555AA670/ELF2_Inspection_Robot/2_STM32_Code/STM32_Project/app/MDK-ARM/build_log.txt

*** Using Compiler 'V5.06 update 5 (build 528)', folder: 'C:\Keil_v5\ARM\ARMCC\Bin'
Rebuild target 'app'
assembling startup_stm32g431xx.s...
compiling OLED_Data.c...
compiling my_spi.c...
compiling stm32g4xx_hal_flash_ramfunc.c...
compiling stm32g4xx_hal_dma_ex.c...
compiling w25q64.c...
compiling ina219_sensor.c...
compiling stm32g4xx_hal_uart.c...
compiling main.c...
../Core/Src/main.c(143): warning:  #550-D: variable "servo_imu_pid_integral"  was set but never used
  static float servo_imu_pid_integral = 0.0f;
../Core/Src/main.c(144): warning:  #550-D: variable "servo_imu_pid_prev_error"  was set but never used
  static float servo_imu_pid_prev_error = 0.0f;
../Core/Src/main.c: 2 warnings, 0 errors
compiling stm32g4xx_it.c...
compiling stm32g4xx_hal_rcc.c...
compiling uart2_oled.c...
compiling icm42688_imu.c...
compiling motor.c...
../Core/Src/motor.c(35): warning:  #550-D: variable "motor_left_mode"  was set but never used
  static MotorDriveMode motor_left_mode = MOTOR_DRIVE_STOP;
../Core/Src/motor.c(36): warning:  #550-D: variable "motor_right_mode"  was set but never used
  static MotorDriveMode motor_right_mode = MOTOR_DRIVE_STOP;
../Core/Src/motor.c: 2 warnings, 0 errors
compiling my_rtc.c...
compiling stm32g4xx_hal_cortex.c...
compiling servo.c...
compiling board.c...
compiling stm32g4xx_hal_flash.c...
compiling stm32g4xx_hal.c...
compiling stm32g4xx_hal_gpio.c...
compiling stm32g4xx_hal_flash_ex.c...
compiling stm32g4xx_hal_rtc.c...
compiling stm32g4xx_hal_pwr.c...
compiling fusion_tracker.c...
compiling stm32g4xx_hal_rcc_ex.c...
compiling stm32g4xx_hal_msp.c...
compiling stm32g4xx_hal_rtc_ex.c...
compiling stm32g4xx_hal_dma.c...
compiling stm32g4xx_hal_pwr_ex.c...
compiling stm32g4xx_hal_exti.c...
compiling stm32g4xx_hal_uart_ex.c...
compiling OLED.c...
