555AA670/ELF2_Inspection_Robot/2_STM32_Code/STM32_Project/G431bootloader/MDK-ARM/build_log.txt

*** Using Compiler 'V5.06 update 5 (build 528)', folder: 'C:\Keil_v5\ARM\ARMCC\Bin'
Build target 'G431bootloader'
compiling main.c...
linking...
Program Size: Code=8010 RO-data=530 RW-data=52 ZI-data=3692  
FromELF: creating hex file...
"G431bootloader\G431bootloader.axf" - 0 Error(s), 0 Warning(s).
Build Time Elapsed:  00:00:02
