555AA670/ELF2_Inspection_Robot/2_STM32_Code/STM32_Project/app/Core/Src/my_rtc.c

#include "my_rtc.h"

RTC_HandleTypeDef hrtc;
volatile uint8_t rtc_alarm_triggered = 0;

void MyRTC_Init(void)
{
  RCC_OscInitTypeDef RCC_OscInitStruct = {0};
  RCC_PeriphCLKInitTypeDef PeriphClkInit = {0};

  /* Enable LSE clock */
  RCC_OscInitStruct.OscillatorType = RCC_OSCILLATORTYPE_LSE;
  RCC_OscInitStruct.LSEState = RCC_LSE_ON;
  if (HAL_RCC_OscConfig(&RCC_OscInitStruct) != HAL_OK)
  {
    Error_Handler();
  }

  /* Select LSE as RTC clock source */
  PeriphClkInit.PeriphClockSelection = RCC_PERIPHCLK_RTC;
  PeriphClkInit.RTCClockSelection = RCC_RTCCLKSOURCE_LSE;
  if (HAL_RCCEx_PeriphCLKConfig(&PeriphClkInit) != HAL_OK)
  {
    Error_Handler();
  }

  /* Enable RTC Clock */
  __HAL_RCC_RTC_ENABLE();

  hrtc.Instance = RTC;
  hrtc.Init.HourFormat = RTC_HOURFORMAT_24;
  hrtc.Init.AsynchPrediv = 127;
  hrtc.Init.SynchPrediv = 255; // LSE is 32768Hz (32768 / 128 = 256) -> 255
  hrtc.Init.OutPut = RTC_OUTPUT_DISABLE;
  hrtc.Init.OutPutRemap = RTC_OUTPUT_REMAP_NONE;
  hrtc.Init.OutPutPolarity = RTC_OUTPUT_POLARITY_HIGH;
  hrtc.Init.OutPutType = RTC_OUTPUT_TYPE_OPENDRAIN;
  hrtc.Init.OutPutPullUp = RTC_OUTPUT_PULLUP_NONE;
  
  if (HAL_RTC_Init(&hrtc) != HAL_OK)
  {
    Error_Handler();
  }

  /* Check if RTC is already configured by reading Backup Register */
  if (HAL_RTCEx_BKUPRead(&hrtc, RTC_BKP_DR1) != 0x32F2)
  {
    /* Set Time: 12:00:00 */
    MyRTC_SetTime(12, 0, 0);

    /* Set Date: 2026-01-01 */
    RTC_DateTypeDef sDate = {0};
    sDate.Year = 26;
    sDate.Month = RTC_MONTH_JANUARY;
    sDate.Date = 1;
    sDate.WeekDay = RTC_WEEKDAY_THURSDAY;
    if (HAL_RTC_SetDate(&hrtc, &sDate, RTC_FORMAT_BIN) != HAL_OK)
    {
      Error_Handler();
    }

    HAL_RTCEx_BKUPWrite(&hrtc, RTC_BKP_DR1, 0x32F2);
  }
}

void MyRTC_SetTime(uint8_t hours, uint8_t minutes, uint8_t seconds)
{
  RTC_TimeTypeDef sTime = {0};
  sTime.Hours = hours;
  sTime.Minutes = minutes;
  sTime.Seconds = seconds;
  sTime.DayLightSaving = RTC_DAYLIGHTSAVING_NONE;
  sTime.StoreOperation = RTC_STOREOPERATION_RESET;

  HAL_RTC_SetTime(&hrtc, &sTime, RTC_FORMAT_BIN);
}

void MyRTC_GetTime(uint8_t *hours, uint8_t *minutes, uint8_t *seconds)
{
  RTC_TimeTypeDef sTime = {0};
  RTC_DateTypeDef sDate = {0};

  /* Must read time then date to unlock the shadow registers */
  HAL_RTC_GetTime(&hrtc, &sTime, RTC_FORMAT_BIN);
  HAL_RTC_GetDate(&hrtc, &sDate, RTC_FORMAT_BIN);

  if (hours) *hours = sTime.Hours;
  if (minutes) *minutes = sTime.Minutes;
  if (seconds) *seconds = sTime.Seconds;
}

void RTC_WKUP_IRQHandler(void)
{
  HAL_RTCEx_WakeUpTimerIRQHandler(&hrtc);
}

void MyRTC_SetAlarmA(uint8_t hours, uint8_t minutes, uint8_t seconds)
{
  RTC_AlarmTypeDef sAlarm = {0};

  sAlarm.AlarmTime.Hours = hours;
  sAlarm.AlarmTime.Minutes = minutes;
  sAlarm.AlarmTime.Seconds = seconds;
  sAlarm.AlarmTime.SubSeconds = 0;
  sAlarm.AlarmTime.DayLightSaving = RTC_DAYLIGHTSAVING_NONE;
  sAlarm.AlarmTime.StoreOperation = RTC_STOREOPERATION_RESET;
  sAlarm.AlarmMask = RTC_ALARMMASK_DATEWEEKDAY; // 忽略日期，仅匹配时分秒
  sAlarm.AlarmSubSecondMask = RTC_ALARMSUBSECONDMASK_ALL;
  sAlarm.AlarmDateWeekDaySel = RTC_ALARMDATEWEEKDAYSEL_DATE;
  sAlarm.AlarmDateWeekDay = 1;
  sAlarm.Alarm = RTC_ALARM_A;

  HAL_RTC_SetAlarm_IT(&hrtc, &sAlarm, RTC_FORMAT_BIN);
  
  /* Enable the Alarm IRQ */
  HAL_NVIC_SetPriority(RTC_Alarm_IRQn, 1, 0);
  HAL_NVIC_EnableIRQ(RTC_Alarm_IRQn);
}

void HAL_RTC_AlarmAEventCallback(RTC_HandleTypeDef *hrtc)
{
  rtc_alarm_triggered = 1;
}
