555AA670/ELF2_Inspection_Robot/2_STM32_Code/STM32_Project/app/Core/Inc/w25q64.h

#ifndef __W25Q64_H
#define __W25Q64_H

#include "main.h"

void W25Q64_Init(void);
void W25Q64_ReadID(uint8_t *MID, uint16_t *DID);
void W25Q64_PageProgram(uint32_t Address, uint8_t *DataArray, uint16_t Count);
void W25Q64_SectorErase(uint32_t Address);
void W25Q64_ReadData(uint32_t Address, uint8_t *DataArray, uint32_t Count);

#endif
