555AA670/ELF2_Inspection_Robot/2_STM32_Code/STM32_Project/app/Core/Src/w25q64.c

#include "w25q64.h"
#include "my_spi.h"
#include "w25q64_ins.h"

void W25Q64_Init(void)
{
    MySPI_Init();
}

void W25Q64_ReadID(uint8_t *MID, uint16_t *DID)
{
    MySPI_Start();
    MySPI_SwapByte(W25Q64_JEDEC_ID);
    *MID = MySPI_SwapByte(W25Q64_DUMMY_BYTE);
    *DID = MySPI_SwapByte(W25Q64_DUMMY_BYTE);
    *DID <<= 8;
    *DID |= MySPI_SwapByte(W25Q64_DUMMY_BYTE);
    MySPI_Stop();
}

void W25Q64_WriteEnable(void)
{
    MySPI_Start();
    MySPI_SwapByte(W25Q64_WRITE_ENABLE);
    MySPI_Stop();
}

void W25Q64_WaitBusy(void)
{
    uint32_t Timeout;
    MySPI_Start();
    MySPI_SwapByte(W25Q64_READ_STATUS_REGISTER_1);
    Timeout = 100000;
    while ((MySPI_SwapByte(W25Q64_DUMMY_BYTE) & 0x01) == 0x01)
    {
        Timeout--;
        if (Timeout == 0)
        {
            break;
        }
    }
    MySPI_Stop();
}

void W25Q64_PageProgram(uint32_t Address, uint8_t *DataArray, uint16_t Count)
{
    uint16_t i;
    
    W25Q64_WriteEnable();
    
    MySPI_Start();
    MySPI_SwapByte(W25Q64_PAGE_PROGRAM);
    MySPI_SwapByte(Address >> 16);
    MySPI_SwapByte(Address >> 8);
    MySPI_SwapByte(Address);
    for (i = 0; i < Count; i++)
    {
        MySPI_SwapByte(DataArray[i]);
    }
    MySPI_Stop();
    
    W25Q64_WaitBusy();
}

void W25Q64_SectorErase(uint32_t Address)
{
    W25Q64_WriteEnable();
    
    MySPI_Start();
    MySPI_SwapByte(W25Q64_SECTOR_ERASE_4KB);
    MySPI_SwapByte(Address >> 16);
    MySPI_SwapByte(Address >> 8);
    MySPI_SwapByte(Address);
    MySPI_Stop();
    
    W25Q64_WaitBusy();
}

void W25Q64_ReadData(uint32_t Address, uint8_t *DataArray, uint32_t Count)
{
    uint32_t i;
    MySPI_Start();
    MySPI_SwapByte(W25Q64_READ_DATA);
    MySPI_SwapByte(Address >> 16);
    MySPI_SwapByte(Address >> 8);
    MySPI_SwapByte(Address);
    for (i = 0; i < Count; i++)
    {
        DataArray[i] = MySPI_SwapByte(W25Q64_DUMMY_BYTE);
    }
    MySPI_Stop();
}
