555AA670/ELF2_Inspection_Robot/(notices)

Notices in the files:
README.md:
License: MIT
